vikulin/OGK-3D-Models/README.md

# OGK-3D-Models
OpenGammaKit 3D models for printing and complete spectrometer assembly

---

## Preview

OpenGammaKit Enclosure Preview

---
