vikulin/OGK-3D-Models/docs/usb_cable.png

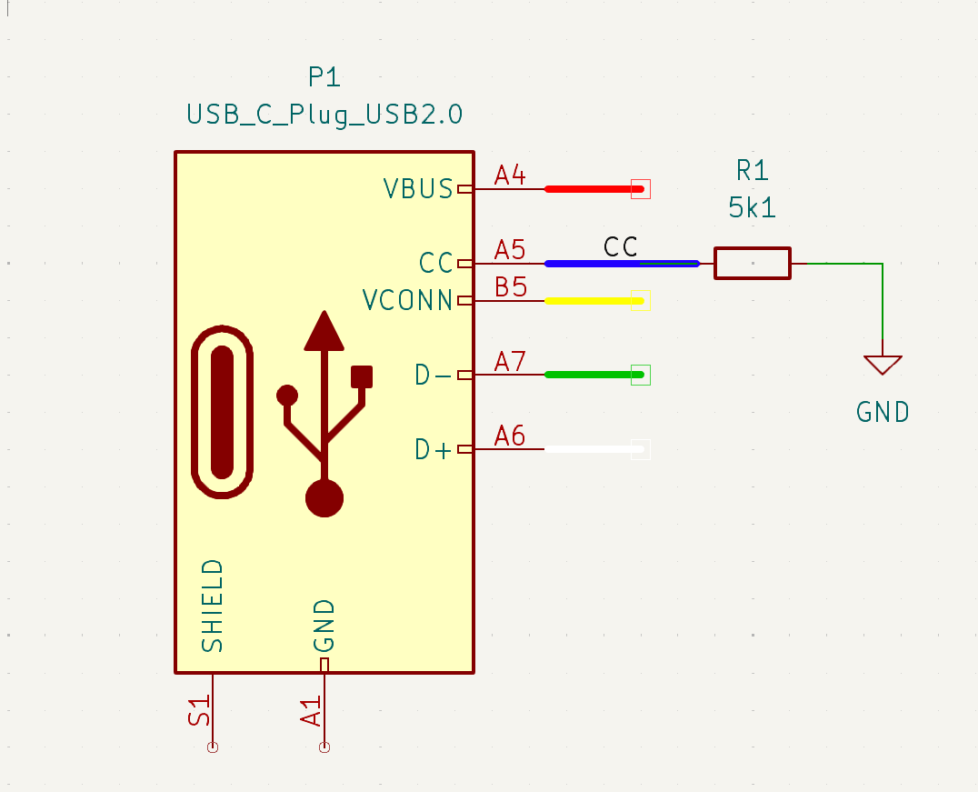
docs/usb_cable.png
