vikulin/OGK-3D-Models/(list of files, cad)

Other CAD files:
Enclosure/bdg4-01-230x50x2x8.blend
Enclosure/ogk-v0.1-166x45x3x8.blend
