vikulin/OGK-3D-Models/(commit log)

2025-05-09 Cap and body models, Almost ready cylinder with thread
    [bdg4-01-body.scad, bdg4-01-cap.scad]
2025-05-10 Body and cap L230D50T2H8
    [bdg4-01-230x50x2x8.blend, bdg4-01-body.scad, bdg4-01-cap.scad]
2025-05-10 Smoothed and scaled
    Downscale factor for cap is 0.995
    [bdg4-01-230x50x2x8.blend]
2025-05-12 Adjusted body size to fit cap thread
    [bdg4-01-230x50x2x8.blend]
2025-05-17 Camera preview fix
    [bdg4-01-230x50x2x8.blend]
2025-11-01 OGK Enclosure v0.1.3
    [ogk-v0.1-177x44x3x8.blend]
2025-11-01 Update release description for STL file
2025-11-01 Improved STL model preview
2025-11-01 Update ogk-v0.1-177x44x3x8.blend
    Thread adjustment
    [ogk-v0.1-177x44x3x8.blend]
2025-11-02 Update ogk-v0.1-177x44x3x8.blend
    Size adjustment
    [ogk-v0.1-177x44x3x8.blend]
2025-11-03 Size adjustments
    [ogk-v0.1-166x45x3x8.blend, ogk-v0.1-177x44x3x8.blend]
2025-11-07 Assembly guide
2026-02-03 Extended cap with 14mm
    [ogk-v0.1-166x45x3x8.blend]
2026-02-03 Fixed normals
    [ogk-v0.1-166x45x3x8.blend]
2026-02-03 USB cable schema update
    [usb-cable.kicad_pcb, usb-cable.kicad_sch]
2026-02-03 Select objects for rendering
    [ogk-v0.1-166x45x3x8.blend]
2026-02-13 3d printing settings
    [ogk-v0.1-166x45x3x8.blend]
